74hc595/TinySimon/schematic.pdf

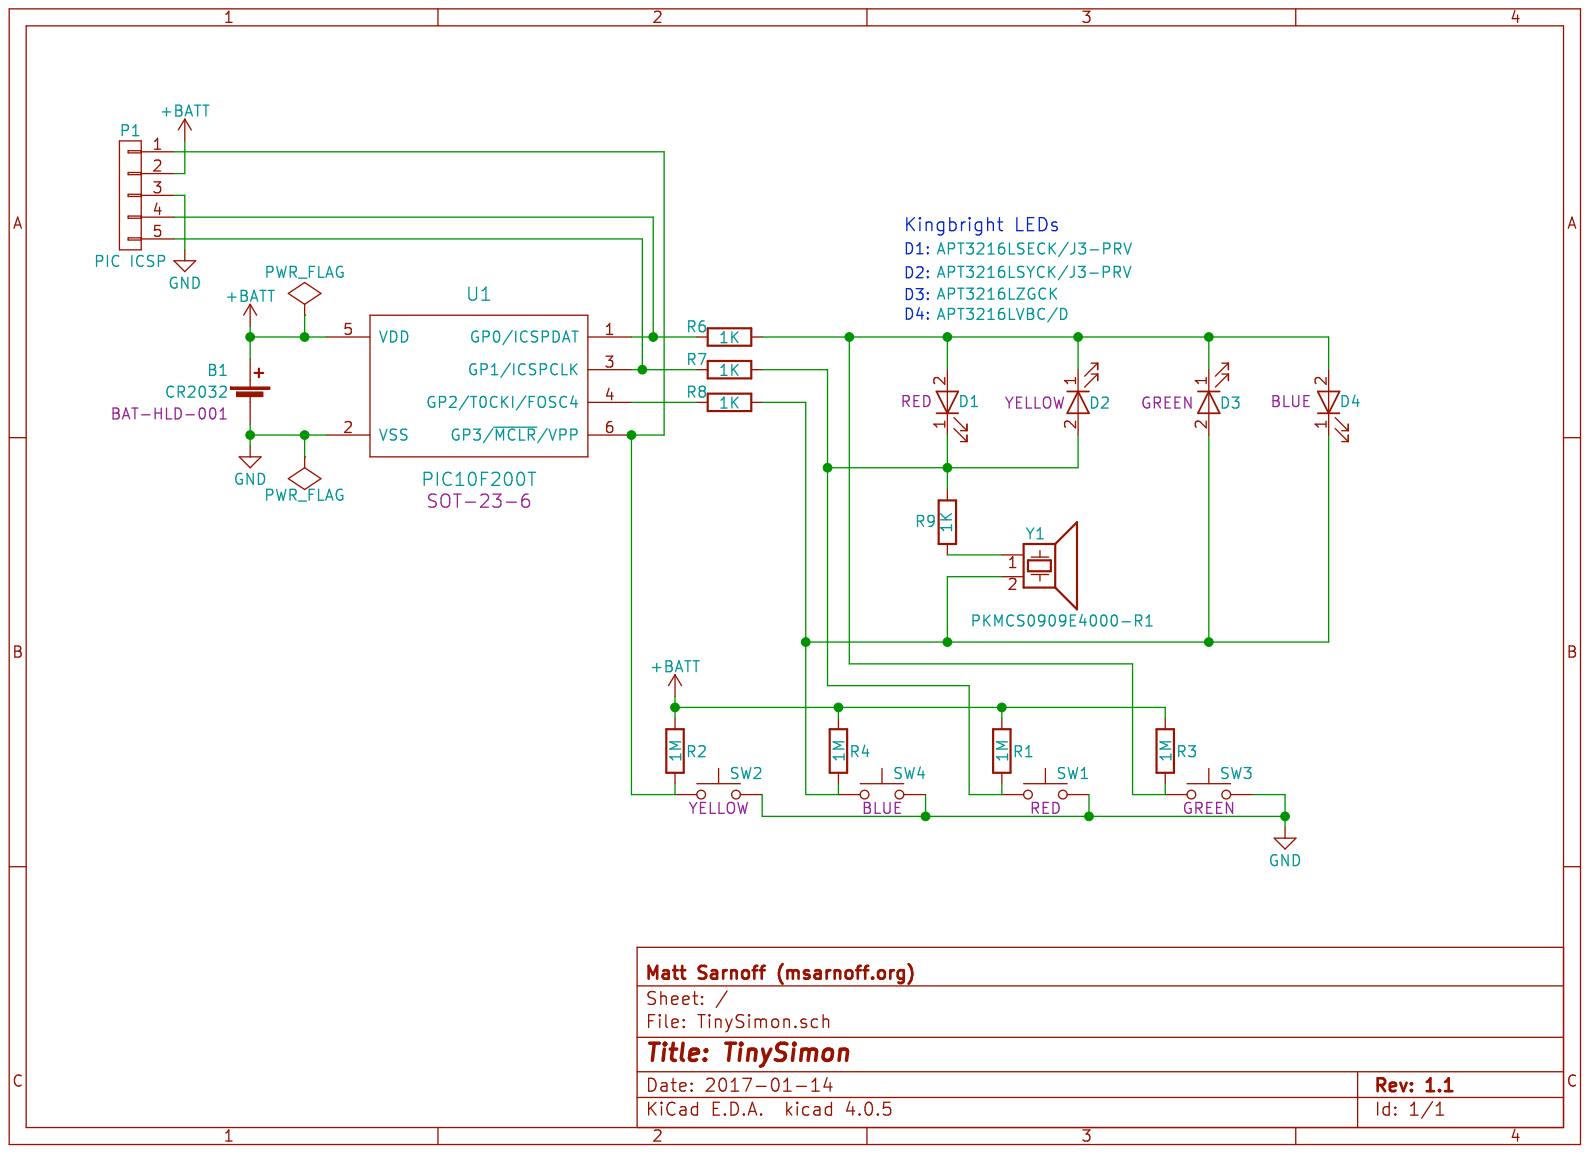
[picture p1: page 1]
