74hc595/TinySimon/board/TinySimon.kicad_pcb

## KiCad design board/TinySimon.kicad_pcb (2017-01-15)

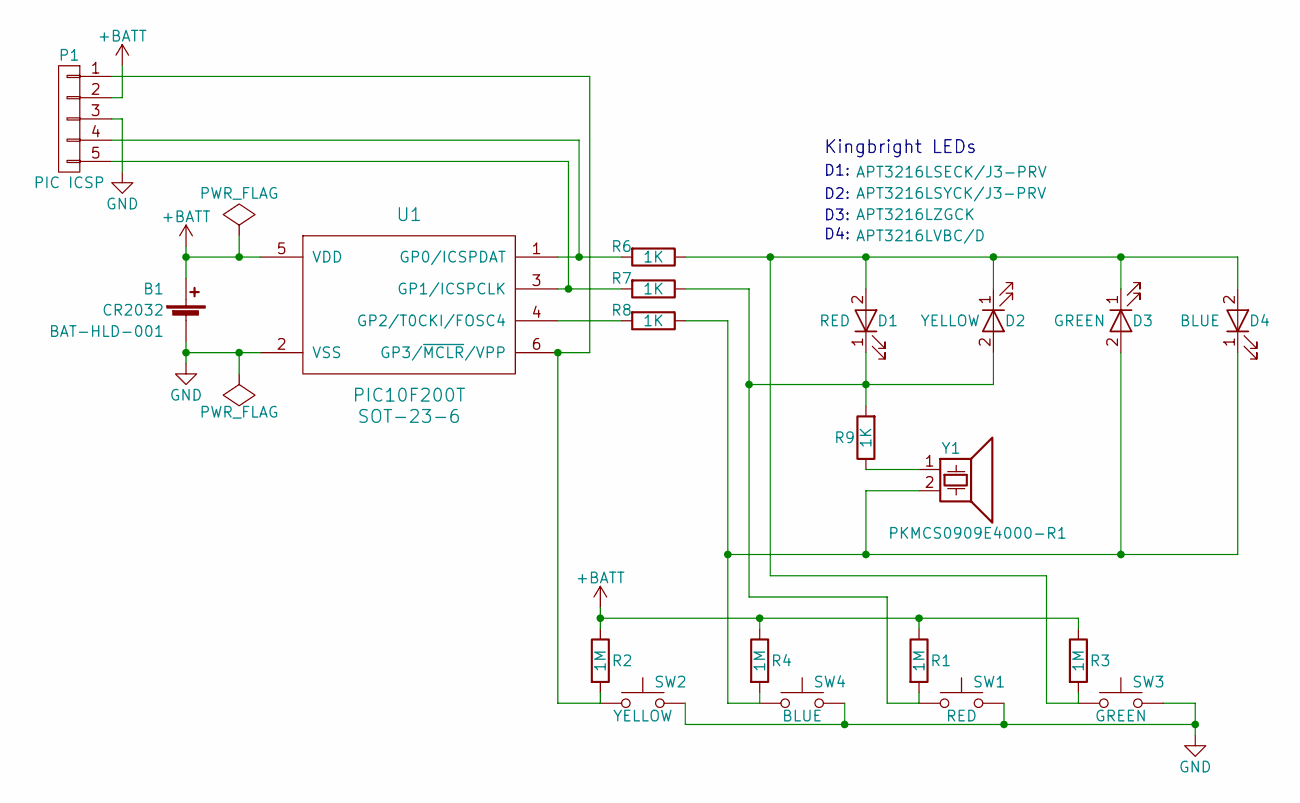
[picture p2: schematic TinySimon.sch]

Parts:
B1: CR2032; BAT-HLD-001
D1: APT3216LSECK/J3-PRV; LED_1206
D2: APT3216LSYCK/J3-PRV; LED_1206
D3: APT3216LZGCK; LED_1206
D4: APT3216LVBC/D; LED_1206
P1: PIC ICSP; Pads_1x5_Pitch1.27mm
R1, R2, R3, R4: 1M; R_1206
R6, R7, R8, R9: 1K; R_1206
SW1, SW2, SW3, SW4: FSMSM; SW_SPST_FSMSM
U1: PIC10F200T; SOT-23-6
Y1: PKMCS0909E4000-R1; Murata_Piezo_SMD_9x9mm

Connections:
+BATT: B1.1 (+), P1.2, R1.1, R2.1, R3.1, R4.1, U1.5 (VDD)
GND: B1.2 (-), P1.3, SW1.2, SW2.2, SW3.2, SW4.2, U1.2 (VSS)
unnamed: D1.1 (K), D2.2 (A), R1.2, R7.1, R9.2, SW1.1
unnamed: D1.2 (A), D2.1 (K), D3.1 (K), D4.2 (A), R3.2, R6.1, SW3.1
unnamed: D3.2 (A), D4.1 (K), R4.2, R8.1, SW4.1, Y1.2
unnamed: P1.1, R2.2, SW2.1, U1.6 (GP3/~MCLR~/VPP)
unnamed: P1.4, R6.2, U1.1 (GP0/ICSPDAT)
unnamed: P1.5, R7.2, U1.3 (GP1/ICSPCLK)
unnamed: R8.2, U1.4 (GP2/T0CKI/FOSC4)
unnamed: R9.1, Y1.1

Notes on the sheet:
Kingbright LEDs
D1:
D2:
D3:
D4:

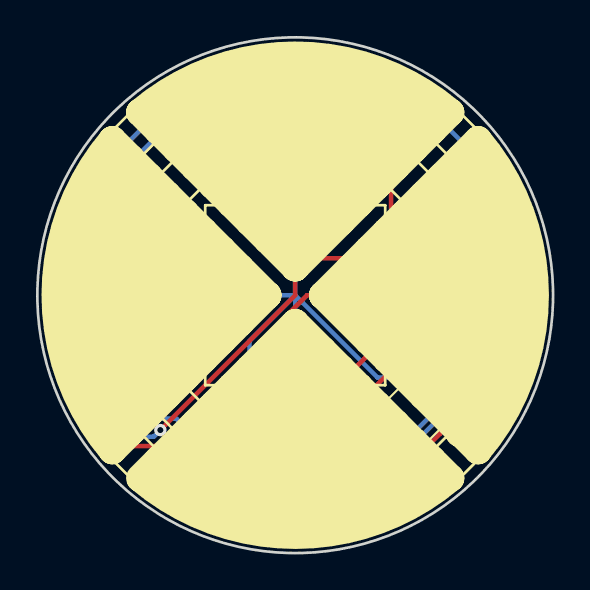
[picture p3: board TinySimon.kicad_pcb from above]

Board: 2 copper layers, 28.7 x 28.7 mm, 20 parts (0 on the bottom side), 10 nets.
