74hc595/TinySimon/(commit log)

2017-01-15 push to github
    [TinySimon.kicad_pcb, TinySimon.sch]
2017-01-15 add pdf schematic and BOM
